KnowFlow/OpenTitrator-Unihiker-K10/ph_titrator/control_logic.h

#ifndef PH_TITRATOR_CONTROL_LOGIC_H
#define PH_TITRATOR_CONTROL_LOGIC_H

#include <stdint.h>

enum class TitrationMode : uint8_t {
  AddBase,
  AddAcid
};

enum class ControlEndpoint : uint8_t {
  Ph,
  Millivolts
};

enum class ControlTrend : uint8_t {
  Increase,
  Decrease
};

enum class TitrantPreset : uint8_t {
  Naoh001,
  Hcl001,
  Edta001,
  Manual
};

enum class TitrationMethod : uint8_t {
  PhEndpoint,
  MvEndpoint,
  EdtaHardness,
  Manual
};

enum class ResultFormula : uint8_t {
  AcidBaseMolar,
  EdtaHardnessCaCO3,
  ManualFactor
};

enum class TitrationAction : uint8_t {
  Dose,
  Wait,
  Done,
  Error
};

enum class TitrationStopReason : uint8_t {
  None,
  TargetReached,
  EquivalencePoint,
  MassLimit,
  TimeLimit,
  InvalidReading,
  SensorFault
};

inline float absoluteFloat(float value);

struct TitrationSettings {
  TitrationMode mode = TitrationMode::AddBase;
  ControlEndpoint endpoint = ControlEndpoint::Ph;
  ControlTrend controlTrend = ControlTrend::Increase;
  TitrantPreset titrantPreset = TitrantPreset::Naoh001;
  float targetPh = 7.00f;
  float tolerancePh = 0.05f;
  float targetMillivolts = 0.0f;
  float toleranceMillivolts = 5.0f;
  float maxConsumedGrams = 20.0f;
  float sampleGrams = 20.0f;
  float titrantMolarity = 0.01f;
  ResultFormula resultFormula = ResultFormula::AcidBaseMolar;
  float blankGrams = 0.0f;
  float titrantDensityGramsPerMl = 1.0f;
  float sampleDensityGramsPerMl = 1.0f;
  float manualResultFactor = 1.0f;
  float controlBand = 0.30f;
  float stableDelta = 0.005f;
  uint16_t holdSeconds = 5;
  uint16_t minSettleSeconds = 5;
  uint16_t maxSettleSeconds = 30;
  uint16_t maxTimeSeconds = 1800;
};

struct TitrationDecision {
  TitrationAction action = TitrationAction::Done;
  TitrationStopReason reason = TitrationStopReason::None;
  uint16_t pumpPulseMs = 0;
  uint16_t settleMs = 10000;
};

struct EqpTracker {
  static constexpr uint8_t MaxPoints = 8;
  float usedGrams[MaxPoints] = {};
  float signal[MaxPoints] = {};
  uint8_t count = 0;
  float lastSlope = 0.0f;
  float bestSlope = 0.0f;
  float bestUsedGrams = 0.0f;
  float bestSignal = 0.0f;
  uint8_t slopesAfterBest = 0;
  bool reached = false;

  void reset() {
    count = 0;
    lastSlope = 0.0f;
    bestSlope = 0.0f;
    bestUsedGrams = 0.0f;
    bestSignal = 0.0f;
    slopesAfterBest = 0;
    reached = false;
    for (uint8_t i = 0; i < MaxPoints; i++) {
      usedGrams[i] = 0.0f;
      signal[i] = 0.0f;
    }
  }

  bool add(float used, float value) {
    constexpr float minDoseStepGrams = 0.01f;
    constexpr float minPeakSlope = 10.0f;
    constexpr float dropRatio = 0.55f;
    constexpr uint8_t confirmSlopes = 2;

    if (count > 0 && absoluteFloat(used - usedGrams[count - 1]) < minDoseStepGrams) {
      signal[count - 1] = value;
      return reached;
    }

    if (count == MaxPoints) {
      for (uint8_t i = 1; i < MaxPoints; i++) {
        usedGrams[i - 1] = usedGrams[i];
        signal[i - 1] = signal[i];
      }
      count = MaxPoints - 1;
    }

    usedGrams[count] = used;
    signal[count] = value;
    count++;

    if (count < 2) {
      return reached;
    }

    float dx = usedGrams[count - 1] - usedGrams[count - 2];
    if (absoluteFloat(dx) < minDoseStepGrams) {
      return reached;
    }

    float dy = signal[count - 1] - signal[count - 2];
    lastSlope = absoluteFloat(dy / dx);
    if (lastSlope > bestSlope) {
      bestSlope = lastSlope;
      bestUsedGrams = usedGrams[count - 1];
      bestSignal = signal[count - 1];
      slopesAfterBest = 0;
      return reached;
    }

    if (bestSlope >= minPeakSlope && lastSlope <= bestSlope * dropRatio) {
      if (slopesAfterBest < 255) {
        slopesAfterBest++;
      }
    } else {
      slopesAfterBest = 0;
    }

    if (count >= 4 && bestSlope >= minPeakSlope && slopesAfterBest >= confirmSlopes) {
      reached = true;
    }
    return reached;
  }
};

struct PhFilter {
  static constexpr uint8_t Window = 7;
  int16_t values[Window] = {};
  uint8_t index = 0;
  uint8_t count = 0;

  void reset() {
    index = 0;
    count = 0;
    for (uint8_t i = 0; i < Window; i++) {
      values[i] = 0;
    }
  }

  void add(int16_t raw) {
    values[index] = raw;
    index = (index + 1) % Window;
    if (count < Window) {
      count++;
    }
  }

  bool ready() const {
    return count == Window;
  }

  float filteredRaw() const {
    int16_t sorted[Window];
    for (uint8_t i = 0; i < Window; i++) {
      sorted[i] = values[i];
    }
    for (uint8_t i = 1; i < Window; i++) {
      int16_t key = sorted[i];
      int8_t j = i - 1;
      while (j >= 0 && sorted[j] > key) {
        sorted[j + 1] = sorted[j];
        j--;
      }
      sorted[j + 1] = key;
    }

    int32_t sum = 0;
    for (uint8_t i = 1; i < Window - 1; i++) {
      sum += sorted[i];
    }
    return (float)sum / (float)(Window - 2);
  }
};

struct TitrationDynamics {
  static constexpr uint8_t N = 5;
  float ph[N] = {};
  uint32_t t_ms[N] = {};
  uint8_t count = 0;
  uint8_t idx = 0;

  void reset() {
    count = 0;
    idx = 0;
  }

  void add(float phValue, uint32_t ms) {
    ph[idx] = phValue;
    t_ms[idx] = ms;
    idx = (idx + 1) % N;
    if (count < N) {
      count++;
    }
  }

  float dpH_dt() const {
    if (count < 2) {
      return 0.0f;
    }
    uint8_t i = (idx + N - 1) % N;
    uint8_t j = (idx + N - 2) % N;
    float dt = (t_ms[i] - t_ms[j]) / 1000.0f;
    return dt > 0.001f ? (ph[i] - ph[j]) / dt : 0.0f;
  }

  bool isSteep() const {
    return absoluteFloat(dpH_dt()) > 0.08f;
  }

  bool isSteep(ControlEndpoint endpoint) const {
    float limit = endpoint == ControlEndpoint::Millivolts ? 8.0f : 0.08f;
    return absoluteFloat(dpH_dt()) > limit;
  }

  bool isSettled(float maxAbsDpHPerSecond = 0.005f) const {
    return count >= 3 && absoluteFloat(dpH_dt()) <= maxAbsDpHPerSecond;
  }

  bool isSettled(ControlEndpoint endpoint) const {
    float limit = endpoint == ControlEndpoint::Millivolts ? 0.5f : 0.005f;
    return count >= 3 && absoluteFloat(dpH_dt()) <= limit;
  }

  bool isSettledWithin(float maxAbsDeltaPerSecond) const {
    return count >= 3 && absoluteFloat(dpH_dt()) <= maxAbsDeltaPerSecond;
  }

  bool isOvershooting(TitrationMode mode, float target) const {
    ControlTrend trend = mode == TitrationMode::AddBase ? ControlTrend::Increase : ControlTrend::Decrease;
    return isOvershooting(trend, ControlEndpoint::Ph, target);
  }

  bool isOvershooting(ControlTrend trend, ControlEndpoint endpoint, float target) const {
    if (count < 2) {
      return false;
    }
    float d = dpH_dt();
    uint8_t i = (idx + N - 1) % N;
    float margin = endpoint == ControlEndpoint::Millivolts ? 2.0f : 0.02f;
    bool doseRaisesValue = trend == ControlTrend::Increase;
    if (doseRaisesValue) {
      return ph[i] > target + margin && d > 0.0f;
    } else {
      return ph[i] < target - margin && d < 0.0f;
    }
  }
};

inline float absoluteFloat(float value) {
  return value < 0.0f ? -value : value;
}

inline bool elapsedAtLeast(uint32_t now, uint32_t startedAt, uint32_t durationMs) {
  return (uint32_t)(now - startedAt) >= durationMs;
}

inline bool deadlineReached(uint32_t now, uint32_t deadline) {
  return deadline != 0U && (int32_t)(now - deadline) >= 0;
}

struct EndpointHoldTracker {
  void reset() {
    active_ = false;
    startedAtMs_ = 0U;
  }

  bool active() const {
    return active_;
  }

  bool update(
      bool fresh,
      bool inRange,
      uint16_t holdSeconds,
      uint32_t now) {
    if (!fresh) {
      return false;
    }
    if (!inRange) {
      reset();
      return false;
    }
    if (holdSeconds == 0U) {
      return true;
    }
    if (!active_) {
      active_ = true;
      startedAtMs_ = now;
      return false;
    }
    return elapsedAtLeast(now, startedAtMs_, (uint32_t)holdSeconds * 1000UL);
  }

private:
  bool active_ = false;
  uint32_t startedAtMs_ = 0U;
};

inline bool isValidPh(float ph) {
  return ph >= 0.0f && ph <= 14.0f;
}

inline bool isValidMillivolts(float millivolts) {
  return millivolts >= -1000.0f && millivolts <= 1000.0f;
}

inline float controlTarget(const TitrationSettings &settings) {
  return settings.endpoint == ControlEndpoint::Millivolts ? settings.targetMillivolts : settings.targetPh;
}

inline float controlTolerance(const TitrationSettings &settings) {
  return settings.endpoint == ControlEndpoint::Millivolts ? settings.toleranceMillivolts : settings.tolerancePh;
}

inline bool isValidControlValue(const TitrationSettings &settings, float value) {
  return settings.endpoint == ControlEndpoint::Millivolts ? isValidMillivolts(value) : isValidPh(value);
}

inline bool doseIncreasesControlValue(const TitrationSettings &settings) {
  return settings.controlTrend == ControlTrend::Increase;
}

inline bool isEndpointReached(const TitrationSettings &settings, float currentValue) {
  const float target = controlTarget(settings);
  const bool doseRaisesValue = doseIncreasesControlValue(settings);
  if (absoluteFloat(currentValue - target) <= controlTolerance(settings)) {
    return true;
  }
  return doseRaisesValue ? currentValue >= target : currentValue <= target;
}

inline uint16_t clampSettleMs(const TitrationSettings &settings, uint16_t requestedMs) {
  uint32_t minMs = (uint32_t)settings.minSettleSeconds * 1000UL;
  uint32_t maxMs = (uint32_t)settings.maxSettleSeconds * 1000UL;
  if (maxMs < minMs) {
    maxMs = minMs;
  }
  if (requestedMs < minMs) {
    return (uint16_t)(minMs > 65535UL ? 65535UL : minMs);
  }
  if (requestedMs > maxMs) {
    return (uint16_t)(maxMs > 65535UL ? 65535UL : maxMs);
  }
  return requestedMs;
}

inline float computeConsumedGrams(float initialWeightGrams, float currentWeightGrams) {
  float consumed = initialWeightGrams - currentWeightGrams;
  return consumed > 0.0f ? consumed : 0.0f;
}

inline float computeSampleGainGrams(float initialWeightGrams, float currentWeightGrams) {
  float gained = currentWeightGrams - initialWeightGrams;
  return gained > 0.0f ? gained : 0.0f;
}

inline float titrantMolarityForPreset(TitrantPreset preset, float manualMolarity) {
  switch (preset) {
    case TitrantPreset::Naoh001:
    case TitrantPreset::Hcl001:
    case TitrantPreset::Edta001:
      return 0.01f;
    case TitrantPreset::Manual:
      return manualMolarity > 0.0f ? manualMolarity : 0.0f;
  }
  return 0.0f;
}

inline void applyTitrationMethodPreset(TitrationSettings &settings, TitrationMethod method) {
  switch (method) {
    case TitrationMethod::PhEndpoint:
      settings.endpoint = ControlEndpoint::Ph;
      settings.controlTrend = ControlTrend::Increase;
      settings.mode = TitrationMode::AddBase;
      settings.targetPh = 7.00f;
      settings.targetMillivolts = 0.0f;
      settings.titrantPreset = TitrantPreset::Naoh001;
      settings.titrantMolarity = 0.01f;
      settings.resultFormula = ResultFormula::AcidBaseMolar;
      settings.blankGrams = 0.0f;
      settings.titrantDensityGramsPerMl = 1.0f;
      settings.sampleDensityGramsPerMl = 1.0f;
      settings.manualResultFactor = 1.0f;
      settings.maxConsumedGrams = 20.0f;
      settings.sampleGrams = 20.0f;
      settings.controlBand = 0.30f;
      settings.stableDelta = 0.005f;
      settings.holdSeconds = 5;
      settings.minSettleSeconds = 5;
      settings.maxSettleSeconds = 30;
      settings.maxTimeSeconds = 1800;
      break;
    case TitrationMethod::MvEndpoint:
      settings.endpoint = ControlEndpoint::Millivolts;
      settings.controlTrend = ControlTrend::Increase;
      settings.mode = TitrationMode::AddBase;
      settings.targetMillivolts = 0.0f;
      settings.titrantPreset = TitrantPreset::Manual;
      settings.titrantMolarity = 0.01f;
      settings.resultFormula = ResultFormula::ManualFactor;
      settings.blankGrams = 0.0f;
      settings.titrantDensityGramsPerMl = 1.0f;
      settings.sampleDensityGramsPerMl = 1.0f;
      settings.manualResultFactor = 1.0f;
      settings.maxConsumedGrams = 20.0f;
      settings.sampleGrams = 20.0f;
      settings.controlBand = 30.0f;
      settings.stableDelta = 0.5f;
      settings.holdSeconds = 5;
      settings.minSettleSeconds = 5;
      settings.maxSettleSeconds = 30;
      settings.maxTimeSeconds = 1800;
      break;
    case TitrationMethod::EdtaHardness:
      settings.endpoint = ControlEndpoint::Millivolts;
      settings.controlTrend = ControlTrend::Decrease;
      settings.mode = TitrationMode::AddAcid;
      settings.targetMillivolts = 0.0f;
      settings.titrantPreset = TitrantPreset::Edta001;
      settings.titrantMolarity = 0.01f;
      settings.resultFormula = ResultFormula::EdtaHardnessCaCO3;
      settings.blankGrams = 0.0f;
      settings.titrantDensityGramsPerMl = 1.0f;
      settings.sampleDensityGramsPerMl = 1.0f;
      settings.manualResultFactor = 1.0f;
      settings.maxConsumedGrams = 20.0f;
      settings.sampleGrams = 20.0f;
      settings.controlBand = 30.0f;
      settings.stableDelta = 0.5f;
      settings.holdSeconds = 5;
      settings.minSettleSeconds = 5;
      settings.maxSettleSeconds = 30;
      settings.maxTimeSeconds = 1800;
      break;
    case TitrationMethod::Manual:
      settings.titrantPreset = TitrantPreset::Manual;
      settings.resultFormula = ResultFormula::ManualFactor;
      break;
  }
}

inline float netTitrantGrams(float titrantUsedGrams, float blankGrams) {
  float net = titrantUsedGrams - blankGrams;
  return net > 0.0f ? net : 0.0f;
}

inline float gramsToMilliliters(float grams, float densityGramsPerMl) {
  if (grams <= 0.0f || densityGramsPerMl <= 0.0f) {
    return 0.0f;
  }
  return grams / densityGramsPerMl;
}

inline float computeSampleConcentrationMolar(
    float titrantMolarity,
    float titrantUsedGrams,
    float sampleGrams,
    float titrantDensityGramsPerMl = 1.0f,
    float sampleDensityGramsPerMl = 1.0f) {
  float titrantMilliliters = gramsToMilliliters(titrantUsedGrams, titrantDensityGramsPerMl);
  float sampleMilliliters = gramsToMilliliters(sampleGrams, sampleDensityGramsPerMl);
  if (titrantMolarity <= 0.0f || titrantMilliliters <= 0.0f || sampleMilliliters <= 0.0f) {
    return 0.0f;
  }
  return titrantMolarity * titrantMilliliters / sampleMilliliters;
}

inline float computeEdtaHardnessCaCO3MgL(
    float edtaMolarity,
    float titrantUsedGrams,
    float sampleGrams,
    float titrantDensityGramsPerMl = 1.0f,
    float sampleDensityGramsPerMl = 1.0f) {
  float titrantMilliliters = gramsToMilliliters(titrantUsedGrams, titrantDensityGramsPerMl);
  float sampleMilliliters = gramsToMilliliters(sampleGrams, sampleDensityGramsPerMl);
  if (edtaMolarity <= 0.0f || titrantMilliliters <= 0.0f || sampleMilliliters <= 0.0f) {
    return 0.0f;
  }
  constexpr float caco3MilligramsPerMillimole = 100.0869f;
  return edtaMolarity * titrantMilliliters * caco3MilligramsPerMillimole * 1000.0f / sampleMilliliters;
}

inline float computeManualFactorResult(
    float titrantUsedGrams,
    float sampleGrams,
    float manualResultFactor) {
  if (titrantUsedGrams <= 0.0f || sampleGrams <= 0.0f || manualResultFactor == 0.0f) {
    return 0.0f;
  }
  return titrantUsedGrams * manualResultFactor / sampleGrams;
}

inline float computeTitrationResult(
    const TitrationSettings &settings,
    float titrantMolarity,
    float titrantUsedGrams,
    float sampleGrams) {
  const float netUsed = netTitrantGrams(titrantUsedGrams, settings.blankGrams);
  switch (settings.resultFormula) {
    case ResultFormula::AcidBaseMolar:
      return computeSampleConcentrationMolar(
          titrantMolarity,
          netUsed,
          sampleGrams,
          settings.titrantDensityGramsPerMl,
          settings.sampleDensityGramsPerMl);
    case ResultFormula::EdtaHardnessCaCO3:
      return computeEdtaHardnessCaCO3MgL(
          titrantMolarity,
          netUsed,
          sampleGrams,
          settings.titrantDensityGramsPerMl,
          settings.sampleDensityGramsPerMl);
    case ResultFormula::ManualFactor:
      return computeManualFactorResult(netUsed, sampleGrams, settings.manualResultFactor);
  }
  return 0.0f;
}

inline float mapLinear(float value, float inLow, float inHigh, float outLow, float outHigh) {
  return outLow + ((value - inLow) * (outHigh - outLow)) / (inHigh - inLow);
}

inline float computeProbeMillivoltsFromAdsInput(
    float adsInputMillivolts,
    float lowAdsInputMillivolts,
    float lowProbeMillivolts,
    float highAdsInputMillivolts,
    float highProbeMillivolts);

inline float computeProbeMillivoltsFromAdsInput(float adsInputMillivolts) {
  constexpr float alkalineAdsInputMillivolts = 1329.3334f;
  constexpr float alkalineProbeMillivolts = -59.0f;
  constexpr float acidAdsInputMillivolts = 2387.3333f;
  constexpr float acidProbeMillivolts = 296.0f;
  return computeProbeMillivoltsFromAdsInput(
      adsInputMillivolts,
      alkalineAdsInputMillivolts,
      alkalineProbeMillivolts,
      acidAdsInputMillivolts,
      acidProbeMillivolts);
}

inline float computeProbeMillivoltsFromAdsInput(
    float adsInputMillivolts,
    float lowAdsInputMillivolts,
    float lowProbeMillivolts,
    float highAdsInputMillivolts,
    float highProbeMillivolts) {
  return mapLinear(
      adsInputMillivolts,
      lowAdsInputMillivolts,
      highAdsInputMillivolts,
      lowProbeMillivolts,
      highProbeMillivolts);
}

inline float computePhFromProbeMillivolts(
    float probeMillivolts,
    float lowProbeMillivolts,
    float lowPh,
    float highProbeMillivolts,
    float highPh);

inline float computePhFromProbeMillivolts(float probeMillivolts) {
  constexpr float alkalineProbeMillivolts = -58.0f;
  constexpr float alkalinePh = 8.11f;
  constexpr float acidProbeMillivolts = 296.0f;
  constexpr float acidPh = 2.14f;
  return computePhFromProbeMillivolts(
      probeMillivolts,
      alkalineProbeMillivolts,
      alkalinePh,
      acidProbeMillivolts,
      acidPh);
}

inline float computePhFromProbeMillivolts(
    float probeMillivolts,
    float lowProbeMillivolts,
    float lowPh,
    float highProbeMillivolts,
    float highPh) {
  return mapLinear(
      probeMillivolts,
      lowProbeMillivolts,
      highProbeMillivolts,
      lowPh,
      highPh);
}

inline float clampFloat(float value, float low, float high) {
  if (value < low) {
    return low;
  }
  if (value > high) {
    return high;
  }
  return value;
}

inline bool isSensorFaultRaw10Bit(int rawValue) {
  return rawValue == 0 || rawValue == 1023;
}

inline int adsRawToAnalog10Bit(int16_t adsRaw) {
  int scaled = (int)((adsRaw + 16) / 32);
  if (scaled < 0) {
    return 0;
  }
  if (scaled > 1023) {
    return 1023;
  }
  return scaled;
}

inline TitrationDecision decideAdaptiveDose(
    const TitrationSettings &settings,
    float currentValue,
    float consumedGrams,
    const TitrationDynamics &dyn) {
  TitrationDecision d;

  if (!isValidControlValue(settings, currentValue)) {
    d.action = TitrationAction::Error;
    d.reason = TitrationStopReason::InvalidReading;
    return d;
  }

  if (consumedGrams >= settings.maxConsumedGrams) {
    d.action = TitrationAction::Error;
    d.reason = TitrationStopReason::MassLimit;
    return d;
  }

  const float target = controlTarget(settings);
  const bool doseRaisesValue = doseIncreasesControlValue(settings);
  const bool shouldDose = doseRaisesValue ? currentValue < target : currentValue > target;
  if (!shouldDose) {
    d.action = TitrationAction::Done;
    d.reason = TitrationStopReason::TargetReached;
    return d;
  }

  if (dyn.isOvershooting(settings.controlTrend, settings.endpoint, target)) {
    d.action = TitrationAction::Done;
    d.reason = TitrationStopReason::TargetReached;
    return d;
  }

  const float error = absoluteFloat(currentValue - target);
  if (isEndpointReached(settings, currentValue)) {
    d.action = TitrationAction::Done;
    d.reason = TitrationStopReason::TargetReached;
    return d;
  }

  const float slope = dyn.dpH_dt();
  const float driftThreshold = settings.endpoint == ControlEndpoint::Millivolts ? 0.1f : 0.001f;
  const bool driftingTowardTarget = doseRaisesValue ? slope > driftThreshold : slope < -driftThreshold;
  const float predictiveStopMargin =
      settings.endpoint == ControlEndpoint::Millivolts
          ? (settings.controlTrend == ControlTrend::Decrease ? 15.0f : 10.0f)
          : (settings.controlTrend == ControlTrend::Decrease ? 0.15f : 0.10f);
  if (error <= predictiveStopMargin && driftingTowardTarget) {
    d.action = TitrationAction::Done;
    d.reason = TitrationStopReason::TargetReached;
    return d;
  }

  const bool steep = dyn.isSteep(settings.endpoint);
  const float farError = settings.controlBand * 3.0f;
  const float mediumError = settings.controlBand;
  const float nearError = settings.controlBand * 0.33f;
  if (settings.endpoint == ControlEndpoint::Ph && driftingTowardTarget) {
    float watchZone = doseRaisesValue ? target - 1.5f : target + 1.5f;
    bool inWatchZone = doseRaisesValue ? currentValue >= watchZone : currentValue <= watchZone;
    if (inWatchZone) {
      d.action = TitrationAction::Wait;
      d.settleMs = clampSettleMs(settings, 20000);
      return d;
    }
  }
  if (steep) {
    d.action = TitrationAction::Dose;
    d.pumpPulseMs = 25;
    d.settleMs = clampSettleMs(settings, 15000);
  } else if (error > farError) {
    d.action = TitrationAction::Dose;
    d.pumpPulseMs = 450;
    d.settleMs = clampSettleMs(settings, 5000);
  } else if (error > mediumError) {
    d.action = TitrationAction::Dose;
    d.pumpPulseMs = 150;
    d.settleMs = clampSettleMs(settings, 8000);
  } else if (error > nearError) {
    d.action = TitrationAction::Dose;
    d.pumpPulseMs = 60;
    d.settleMs = clampSettleMs(settings, 12000);
  } else {
    d.action = TitrationAction::Dose;
    d.pumpPulseMs = 25;
    d.settleMs = clampSettleMs(settings, 15000);
  }
  return d;
}

inline TitrationDecision decideEqpDose(
    const TitrationSettings &settings,
    float currentValue,
    float consumedGrams,
    const EqpTracker &eqp) {
  TitrationDecision d;

  if (!isValidControlValue(settings, currentValue)) {
    d.action = TitrationAction::Error;
    d.reason = TitrationStopReason::InvalidReading;
    return d;
  }

  if (consumedGrams >= settings.maxConsumedGrams) {
    d.action = TitrationAction::Error;
    d.reason = TitrationStopReason::MassLimit;
    return d;
  }

  if (eqp.reached) {
    d.action = TitrationAction::Done;
    d.reason = TitrationStopReason::EquivalencePoint;
    return d;
  }

  d.action = TitrationAction::Dose;
  if (eqp.bestSlope >= 80.0f || eqp.slopesAfterBest > 0) {
    d.pumpPulseMs = 25;
    d.settleMs = clampSettleMs(settings, 15000);
  } else if (eqp.bestSlope >= 30.0f) {
    d.pumpPulseMs = 60;
    d.settleMs = clampSettleMs(settings, 12000);
  } else if (eqp.count < 3) {
    d.pumpPulseMs = 150;
    d.settleMs = clampSettleMs(settings, 8000);
  } else {
    d.pumpPulseMs = 100;
    d.settleMs = clampSettleMs(settings, 10000);
  }
  return d;
}

#endif
