KnowFlow/OpenTitrator-Unihiker-K10/ph_titrator/run_engine.h

#ifndef PH_TITRATOR_RUN_ENGINE_H
#define PH_TITRATOR_RUN_ENGINE_H

#include "run_types.h"

class RunEngine {
public:
  RunEngine();

  RunOutput step(const RunInput &input);
  void reset();
  RunPhase phase() const;
  RunTelemetry telemetry() const;

private:
  RunPhase phase_;
  RunStopReason stopReason_;
  RunPhase pausedPhase_;
  uint32_t fillStartedAtMs_;
  uint32_t lastSampleProgressAtMs_;
  float lastSampleProgressGrams_;
  bool reStabilizingAfterResume_;
  TitrationSettings settings_;
  TitrationDynamics dynamics_;
  EndpointHoldTracker endpointHold_;
  uint32_t runStartedAtMs_;
  uint32_t pulseStartedAtMs_;
  uint32_t settleStartedAtMs_;
  uint32_t activePulseMs_;
  uint32_t activeSettleMs_;
  uint32_t activeMaxSettleMs_;
  EqpTracker eqpTracker_;
  float initialReactorMassGrams_;
  float consumedTitrantGrams_;
  float endpointUsedTitrantGrams_;
  float predoseTargetGrams_;
  bool hasInitialReactorMass_;
  bool hasEndpointUsedTitrantGrams_;
  bool finalizationEmitted_;

  void resetExperimentHistory();
};

#endif
