KnowFlow/OpenTitrator-Unihiker-K10/ph_titrator/factory_auth.example.h

#pragma once
#include <stdint.h>
// Structure example only. Version/iterations are deliberately invalid.
static constexpr uint8_t FACTORY_AUTH_VERSION = 0;
static constexpr uint32_t FACTORY_AUTH_ITERATIONS = 0;
static constexpr uint8_t FACTORY_AUTH_SALT[16] = {};
static constexpr uint8_t FACTORY_AUTH_HASH[32] = {};
