KnowFlow/OpenTitrator-Unihiker-K10/(commit log)

2026-05-28 fix: replace blocking delay() with non-blocking waits and clean up dead code
    - Replace delay() in ADC/Scale/I2C/WiFi with millis()-based non-blocking
    waits that keep OTA and web server responsive during sensor reads
    - Fix millis() overflow risk in scheduleRestart (subtraction pattern)
    - Remove 6 unused display functions and duplicate stateTextShort()
    - Use named COLOR_* constants instead of raw hex in drawDisplay()
    - Extract magic timing numbers to named constants
    - Fix hardcoded Windows path in test files to relative paths
    - Add test name output to Arduino test assertions
    [ph_titrator.ino, ph_titrator_control_test.ino]
2026-05-28 fix: apply voltage divider calibration V0 = Vin * 3 + 1500
    [ph_titrator.ino]
2026-05-28 fix: calibrate probe millivolts and pH conversion
    [control_logic.h, ph_titrator.ino, ph_titrator_control_test.ino]
2026-05-28 feat: add sample dosing and titrant concentration workflow
2026-05-28 Refactor: remove dead code, fix escapes, add OTA support, improve tests
    Changes:
    - control_logic.h: remove unused TitrationDecision, pulseForError, decideTitrationStep, precontrol field
    - ph_titrator.ino: dedup modeLabel/modeText, fix htmlEscape/jsonEscape, add dual-filter comments, add HTTP OTA endpoint
    - Add custom partitions.csv for OTA support
    - tests: replace dead-code tests with computePumpControl boundary tests
    - scripts: add ota_upload.py and ota_upload.ps1
    [partitions.csv]
2026-05-28 refactor: pure pulse titration strategy + pump calibration
    - Replace PWM continuous control with adaptive pulse dosing
    - Far zone: 600ms pulse / 2s settle
    - Medium: 200ms / 3.5s
    - Near: 80ms / 5s
    - Steep slope: 30ms / 8s
    - Add TitrationDynamics tracker with dpH/dt overshoot detection
    - Add Calibrating run state with pump flow-rate calibration routine
    - 2s pulse per pump, weigh before/after, save to Preferences
    - Update tests for decideAdaptiveDose boundary conditions
    - Fix control_logic.h forward declaration for absoluteFloat
    [control_logic.h, ph_titrator.ino, ph_titrator_control_test.ino]
2026-05-28 docs: rewrite README and add bilingual user manual
    - README.md: English project overview with hardware, features, quick start
    - README_CN.md: Chinese version
    - docs/MANUAL.md: detailed English user manual (safety, wiring, workflow, troubleshooting)
    - docs/MANUAL_CN.md: detailed Chinese user manual
2026-05-29 fix: B-key calibration entry, web calibrate button, pump flow display
    - Fix AB combo key ghosting on K10 causing B-key to trigger start-titration instead of calibration
    - Add Calibrate pumps button and flow rate display to web UI
    - Add titrant_gps / sample_gps to JSON API
    - Fix runCalibration static state not reset after cancellation
    - Add pump.update / samplePump.update inside runCalibration loop
    [ph_titrator.ino]
2026-05-29 feat: refine calibration and manual control UI
2026-05-29 fix: slow titration cadence to reduce overshoot
    [control_logic.h, ph_titrator.ino, ph_titrator_control_test.ino]
2026-05-29 fix: wait for pH response before dosing
    [control_logic.h, ph_titrator.ino, ph_titrator_control_test.ino]
2026-05-29 fix: stop titration early on pH drift
    [control_logic.h, ph_titrator_control_test.ino]
2026-05-29 fix: balance titration speed and acid stop margin
    [control_logic.h, ph_titrator.ino, ph_titrator_control_test.ino]
2026-06-01 fix: stabilize scale filtering
    [ph_titrator.ino]
2026-06-02 feat: clarify calibration guidance
2026-06-03 feat: add density correction for titration results
    [control_logic.h, ph_titrator.ino, ph_titrator_control_test.ino]
2026-06-04 fix: keep method when updating run settings
    [ph_titrator.ino]
2026-06-08 Fix: Use printf for key writing, add key validation and SSH debug
2026-06-08 Switch to git-mirror-action with HTTPS source (repo now public)
2026-07-09 Add pump flow control design
2026-07-09 Add pump flow control implementation plan
2026-07-09 Add adjustable pump PWM flow control
2026-07-10 Apply pump flow control and config updates
2026-07-10 Make pump deadlines rollover safe
2026-07-10 Lock pumps during HTTP OTA
2026-07-10 fix OTA lock and endpoint hold safety
    [ph_titrator.ino]
2026-07-12 Add device authentication provisioning
2026-07-12 Document authenticated device workflow
2026-07-12 Prioritize OTA safety lock over reset
    [run_engine.cpp]
2026-07-12 Guard RunEngine against non-finite fill flow
2026-07-13 Fix RunEngine endpoint and settling guards
    [run_engine.cpp]
2026-07-13 Fix RunEngine legacy predose semantics
    [run_engine.cpp]
2026-07-13 Fix emergency stop RunEngine synchronization
    [ph_titrator.ino, run_engine.cpp, run_engine.h, run_types.h]
2026-07-13 Fix run record idle telemetry history
    [ph_titrator.ino]
2026-07-13 Add printable browser run report
2026-07-13 Fix browser run record snapshots
    [ph_titrator.ino]
